Virtex7/Carbonwickelmaschine/README.md

# Carbonwickelmaschine
Maschine zur Herstellung von gewickelten Carbonrohren
