Virtex7/Carbonwickelmaschine/Doku/Pläne gescannt.pdf

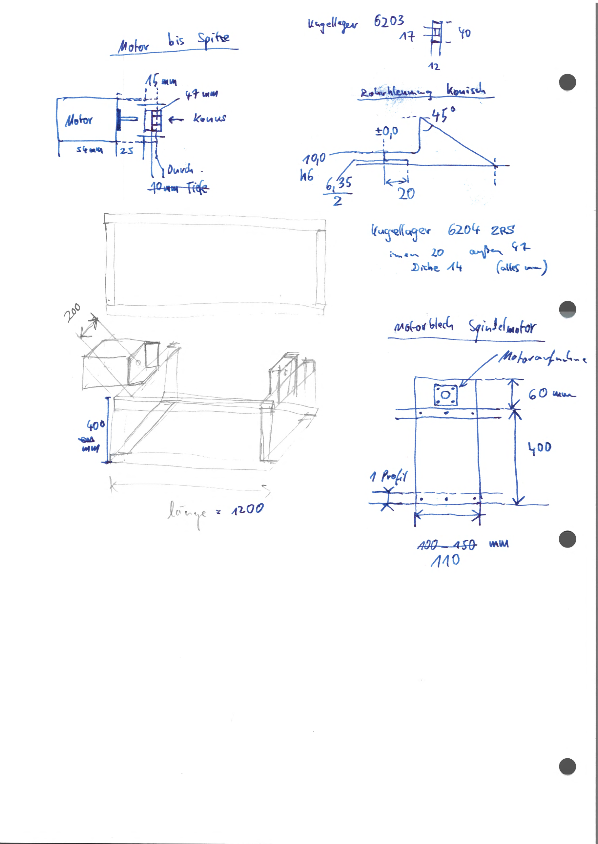
[picture p12: page 1]

00~

# ovv

## (j(jb' ~ fil WIWI

- •

# ~,3..'cr JiY ~l~ -""' (

! ...... „ ..... 07 "-~ ;..~

# '0hn_)}aJ;Y\J} +J07fj St}Z

:+ o'o

()07.V

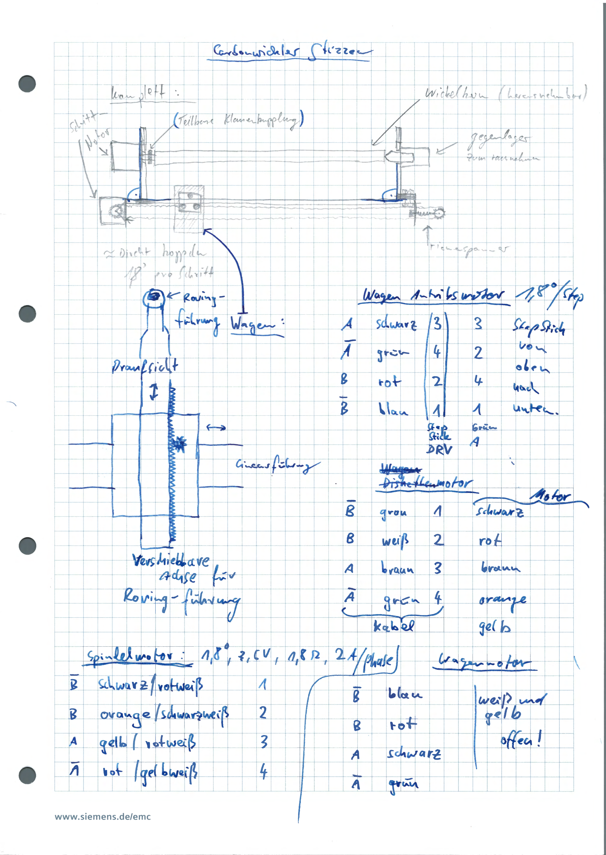
[picture p13: page 2]

l

. h V J -=+--+-l-~--+----1------+- -- -- > 4 | ,, ; l~ ifl ~_iill ,r'ta: -n 1t-i-

-1--_.__ ..-i-- ----+- --+---+----+-'--+--+-1--+--+- - - .--r--t--+--4
, I

o:; •J1 lt"" _. F~) l'- r• - '7- 1

I--+-+---+-~ .,f-- -+--00

1

... . ..._ . ~ ........., - -_ . ... : [ _.!"" ~ ""' I _ +-. ~--+- --

' - 1 q

- -l---j---1--~ --+-- ---B- +-1--+---+---i--+-+-+--+--+ ~ z rt r 11

\.

### oJ. „ v ~

~ -

1

~ .- ·~

# _. -·rr ... IJ -. j

1 1 - 1
