Virtex7/Carbonwickelmaschine/Doku/bilder/carbonwickler_matlab.jpg

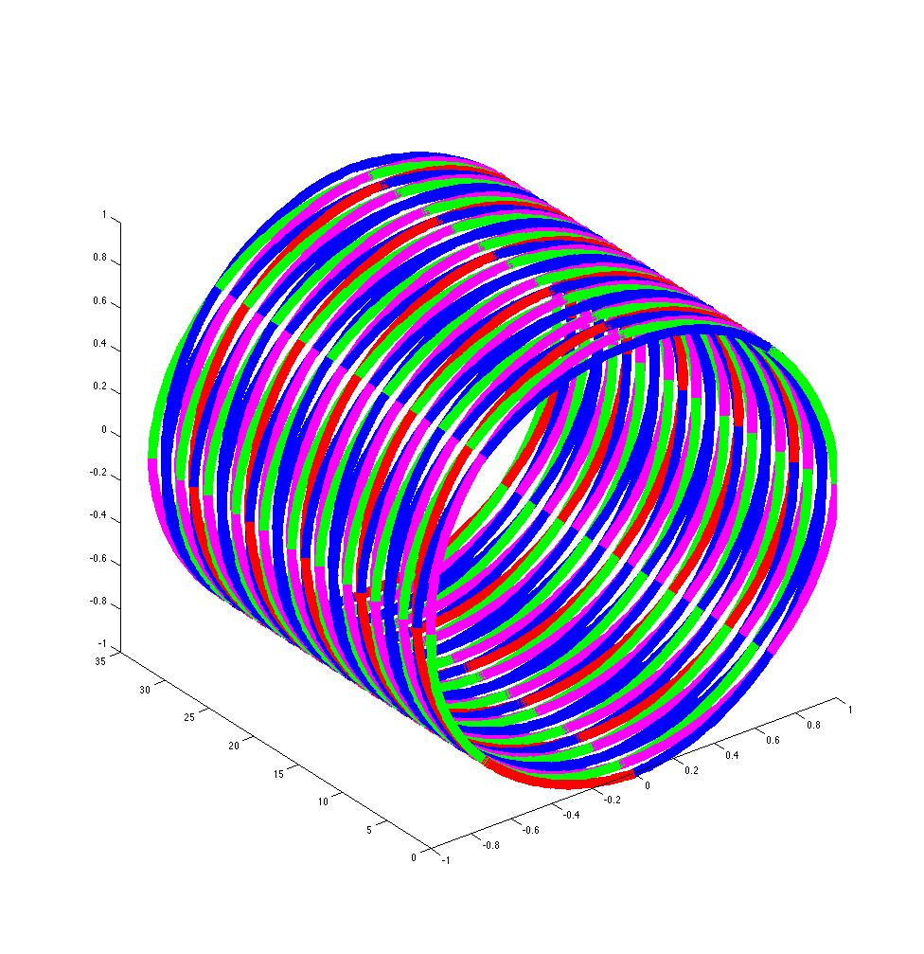
Doku/bilder/carbonwickler_matlab.jpg
