Virtex7/Carbonwickelmaschine/Doku/carbonwickler.png

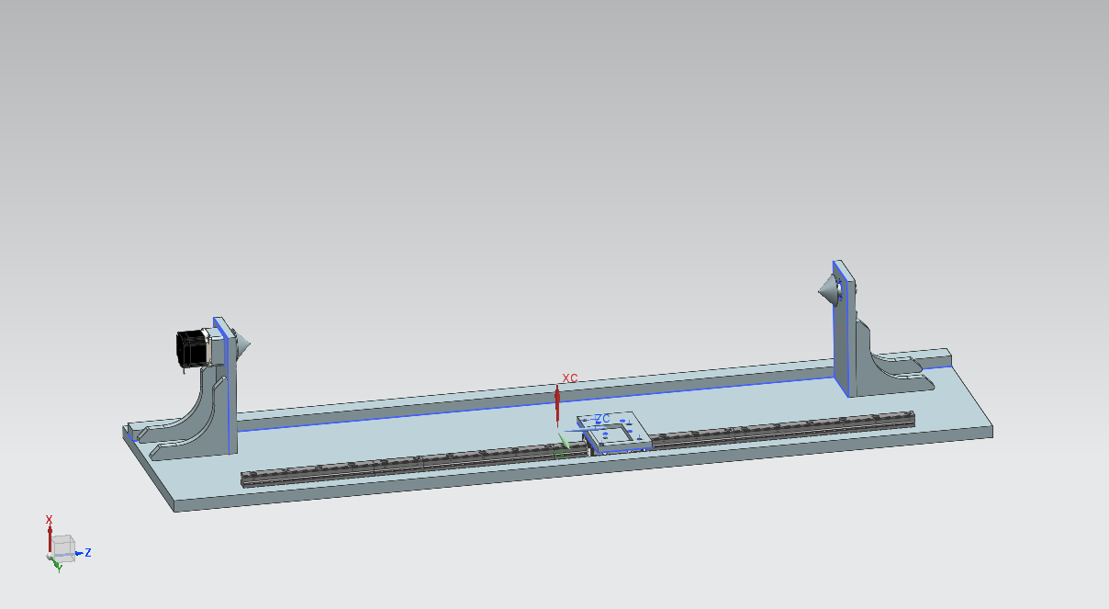
Doku/carbonwickler.png
