Virtex7/Carbonwickelmaschine/Doku/NX_Screenshots/arm_hinten.png

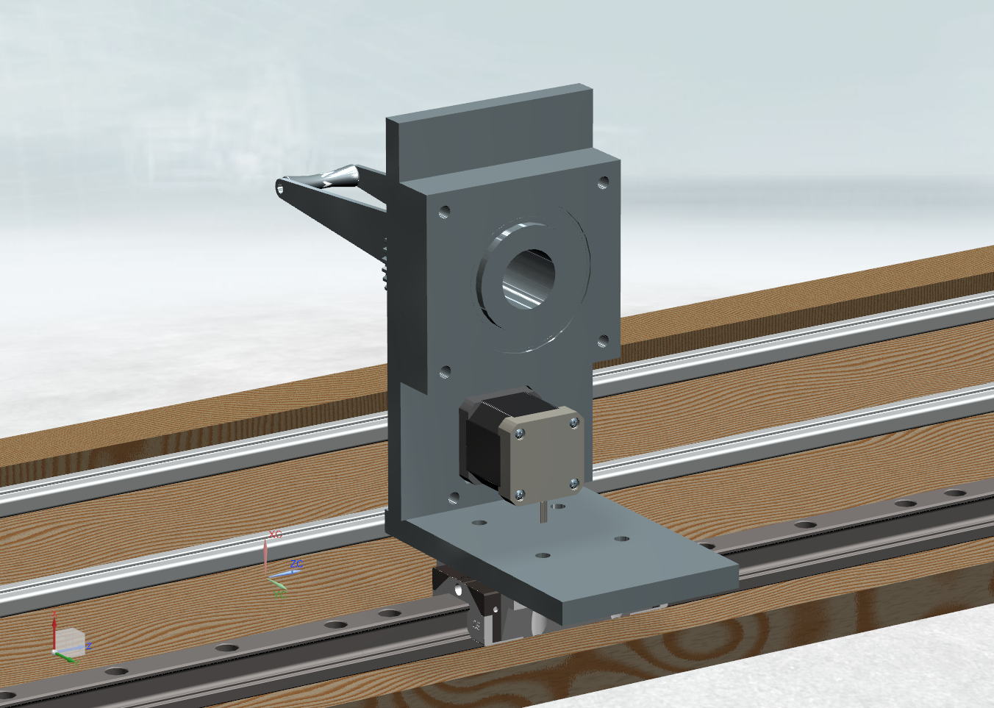
Doku/NX_Screenshots/arm_hinten.png
