Virtex7/Carbonwickelmaschine/Doku/NX_Screenshots/dreharm.png

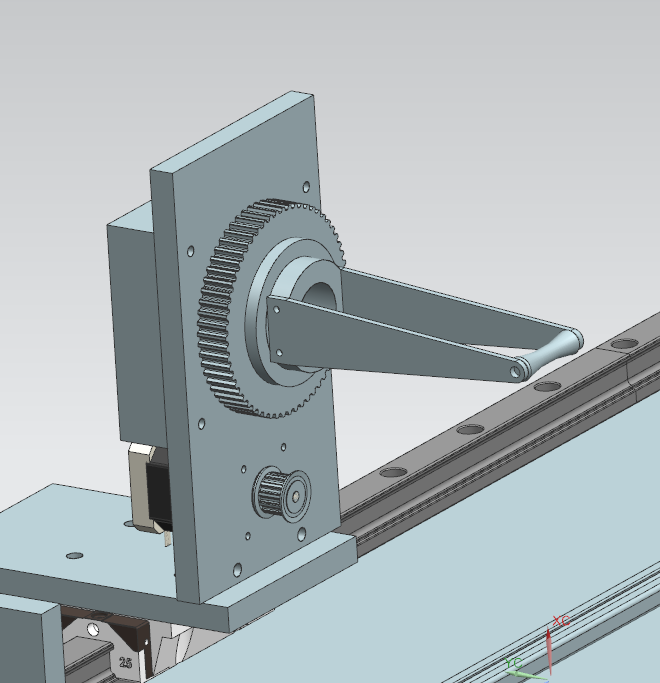
Doku/NX_Screenshots/dreharm.png
