Virtex7/Carbonwickelmaschine/Doku/NX_Screenshots/dreharm_rueckseite.png

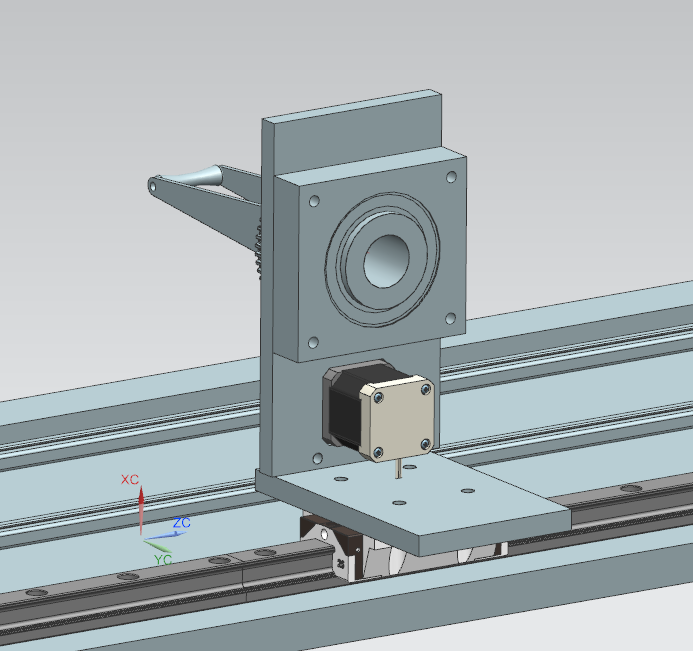
Doku/NX_Screenshots/dreharm_rueckseite.png
