Virtex7/Carbonwickelmaschine/Doku/NX_Screenshots/gesamt2.png

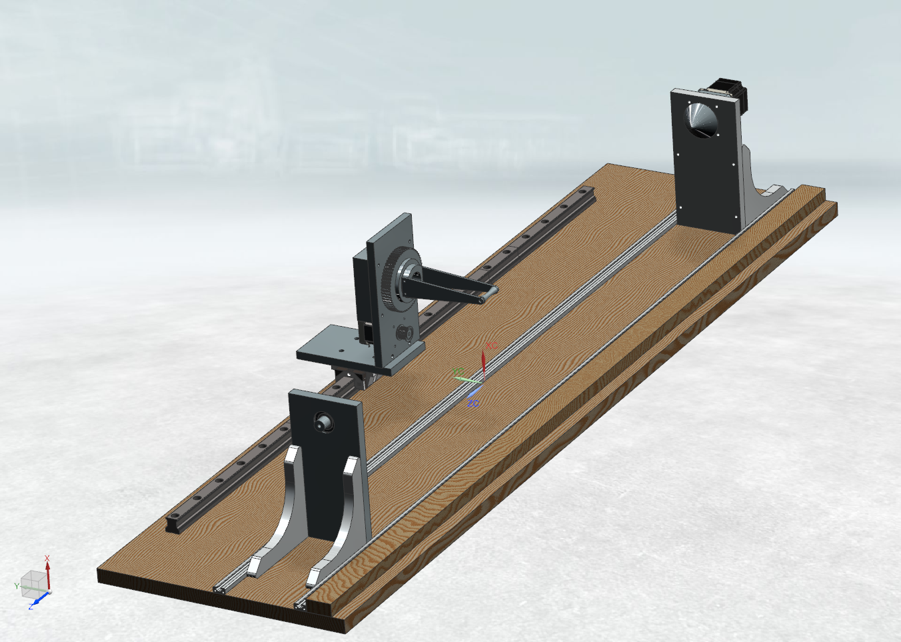
Doku/NX_Screenshots/gesamt2.png
