Virtex7/Carbonwickelmaschine/Doku/NX_Screenshots/gesamt.png

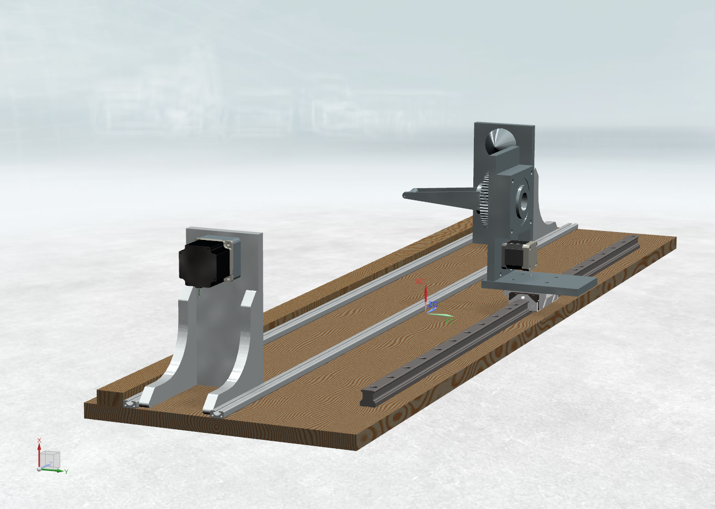
Doku/NX_Screenshots/gesamt.png
