Virtex7/Carbonwickelmaschine/Doku/NX_Screenshots/kugelumlaufführung_wagen.png

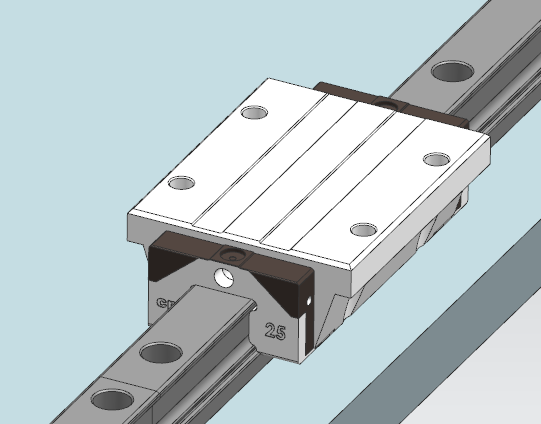
Doku/NX_Screenshots/kugelumlaufführung_wagen.png
