Virtex7/Carbonwickelmaschine/Doku/NX_Screenshots/oben.png

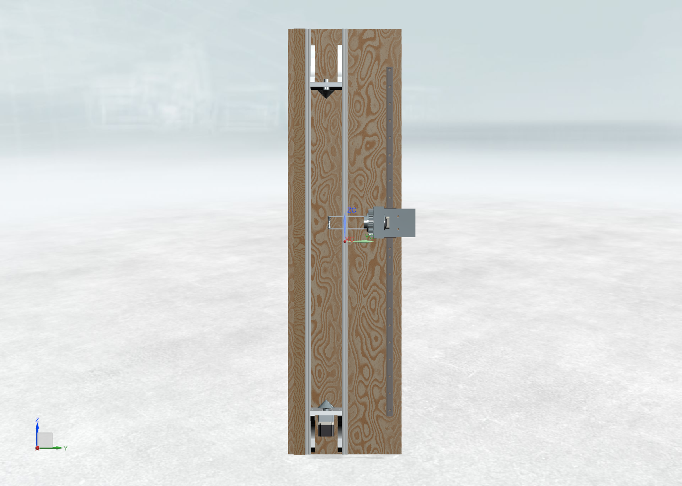
Doku/NX_Screenshots/oben.png
