Virtex7/Carbonwickelmaschine/Doku/NX_Screenshots/reitstock.png

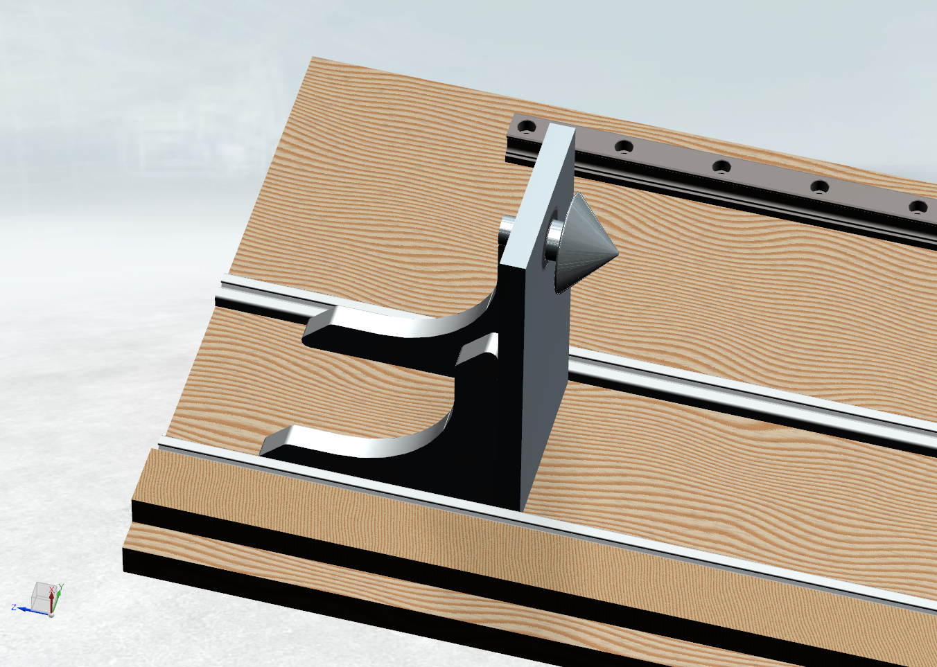
Doku/NX_Screenshots/reitstock.png
