Virtex7/Carbonwickelmaschine/Doku/NX_Screenshots/spindel_hinten.png

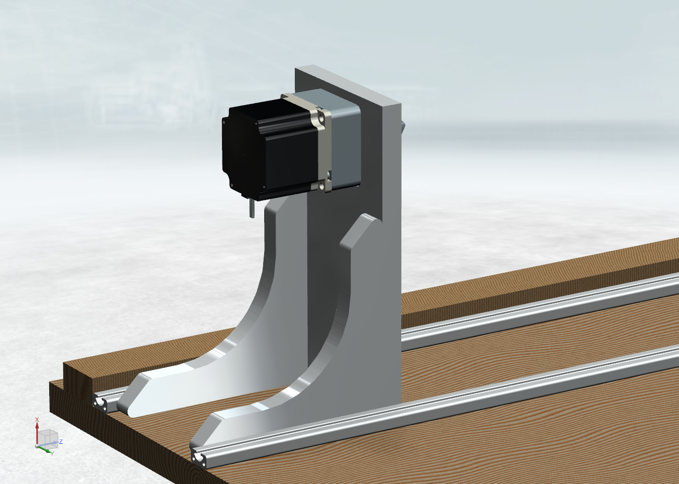
Doku/NX_Screenshots/spindel_hinten.png
