Virtex7/Carbonwickelmaschine/Doku/NX_Screenshots/spindel_rueckseite.png

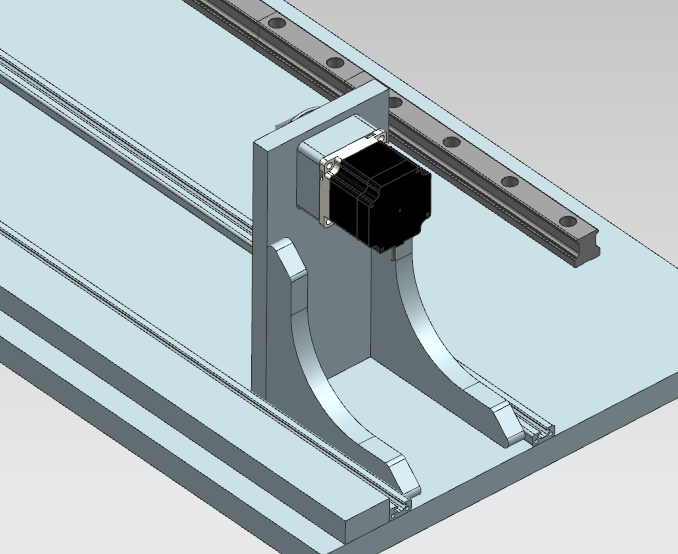
Doku/NX_Screenshots/spindel_rueckseite.png
