Virtex7/Carbonwickelmaschine/Doku/NX_Screenshots/spindel_vorderseite.png

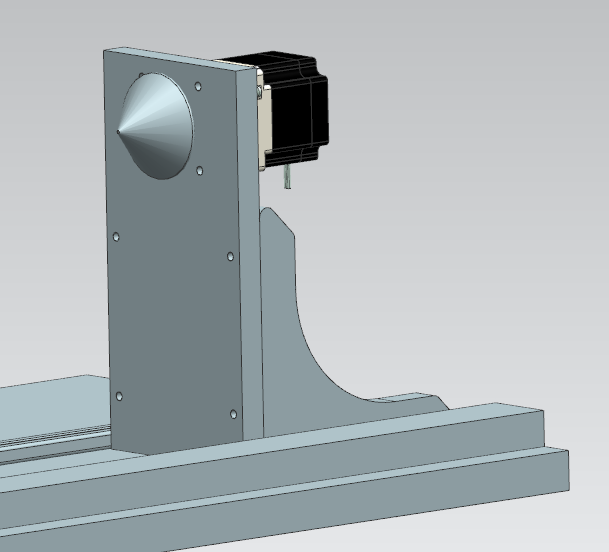
Doku/NX_Screenshots/spindel_vorderseite.png
