Virtex7/Carbonwickelmaschine/3D-Modell/extern/ST5918S3008.stp

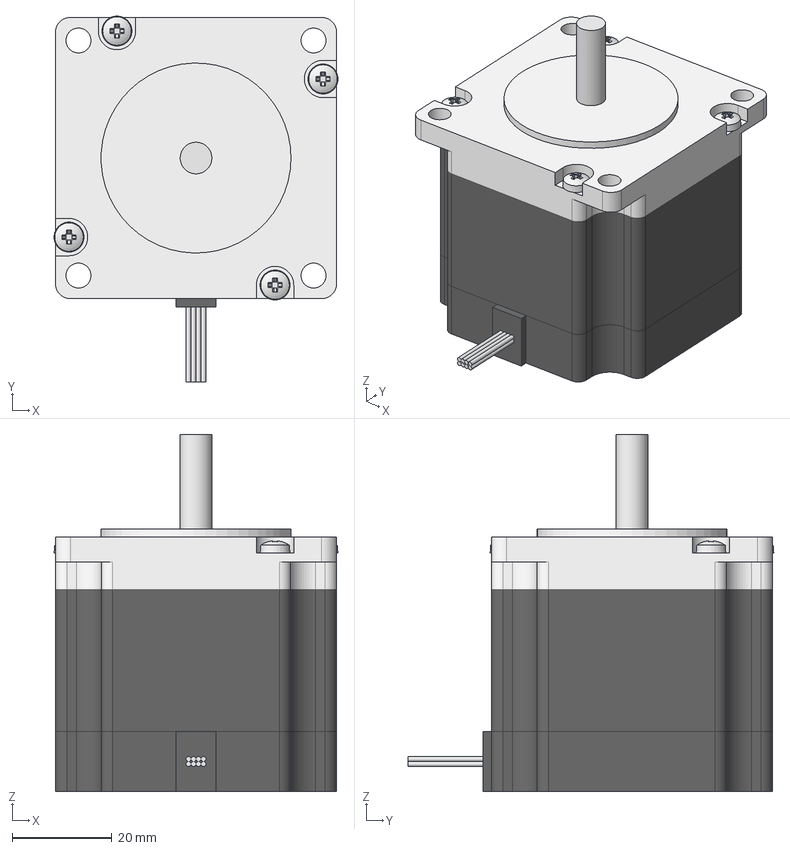
[picture p27: CAD file, 2015-10-22]
3D-Modell/extern/ST5918S3008.stp
56.9 x 73.4 x 71.6 mm
