Virtex7/Carbonwickelmaschine/3D-Modell/extern/62032rsr.stp

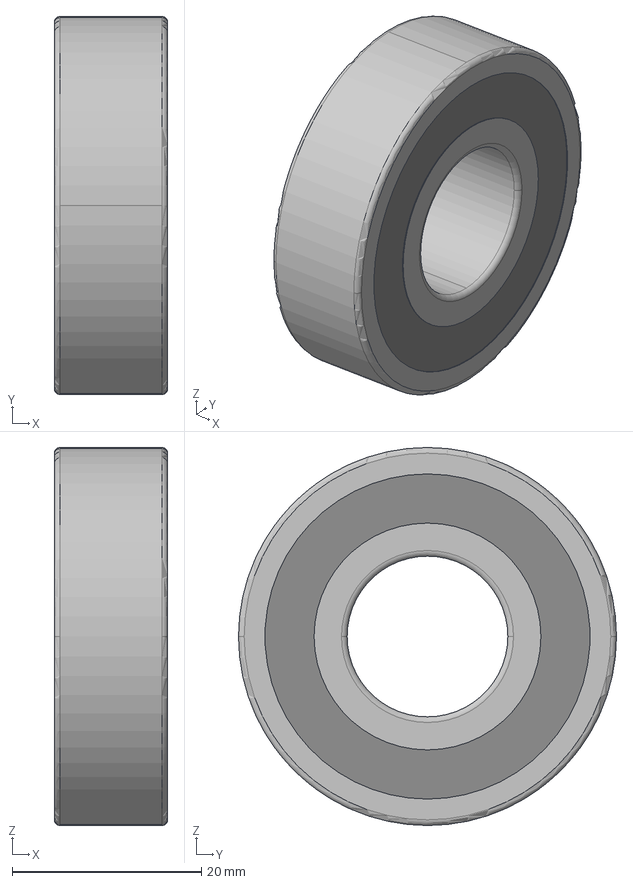
[picture p28: CAD file, 2015-10-22]
3D-Modell/extern/62032rsr.stp
12.0 x 40.0 x 40.0 mm
