Virtex7/Carbonwickelmaschine/(list of files, cad)

Other CAD files:
3D-Modell/1.prt
3D-Modell/1216.prt
3D-Modell/2.prt
3D-Modell/2230.prt
3D-Modell/3.prt
3D-Modell/3244.prt
3D-Modell/4.prt
3D-Modell/4258.prt
3D-Modell/5.prt
3D-Modell/5272.prt
3D-Modell/6.prt
3D-Modell/6203_2RSR.prt
3D-Modell/6286.prt
3D-Modell/7.prt
3D-Modell/7300.prt
3D-Modell/8.prt
3D-Modell/8314.prt
3D-Modell/9.prt
3D-Modell/9328.prt
3D-Modell/AR25M-RAIL.prt
3D-Modell/Aluprofil_20_10_5.prt
3D-Modell/Grundplatte.prt
3D-Modell/HRC25FL-BLOCK.prt
3D-Modell/Montagewinkel150x150.prt
3D-Modell/Nema17Stepper49mm.prt
3D-Modell/Reitstock.prt
3D-Modell/Reitstockblech.prt
3D-Modell/Rillenkugellager_60102RSR.prt
3D-Modell/Rohrkonus_links.prt
3D-Modell/ST5918S3008_stp.prt
3D-Modell/Spindelblech.prt
3D-Modell/Spindelgruppe.prt
3D-Modell/Spindelmotorhalter-fraesen.prt
3D-Modell/Spindelmotorhalter.prt
3D-Modell/Umlenkrolle.prt
3D-Modell/Zahnriemenrad_21T5_12.prt
3D-Modell/Zahnriemenrad_21T5_60.prt
3D-Modell/_HSR15A115015 Rail.prt
3D-Modell/_HSR15ASSQZ Slider.prt
3D-Modell/_hsr_ftht__grease_nipple_joint.prt
3D-Modell/carbonwickler.prt
3D-Modell/carbonwickler_fertigung_montagewinkel.prt
3D-Modell/drehachse.prt
3D-Modell/dreharm_seitenplatten.prt
3D-Modell/dreharm_welle.prt
3D-Modell/extern/1.prt
3D-Modell/extern/2.prt
3D-Modell/extern/3.prt
3D-Modell/extern/4.prt
3D-Modell/extern/5.prt
3D-Modell/extern/6.prt
3D-Modell/extern/6203_2RSR.prt
3D-Modell/extern/7.prt
3D-Modell/extern/8.prt
3D-Modell/extern/9.prt
3D-Modell/extern/ST5918S3008_stp.prt
3D-Modell/fertigung_frontlblech_drehwagen.prt
3D-Modell/fertigung_grundplatte_drehplattenhalter.prt
3D-Modell/fertigung_motorhalter.prt
3D-Modell/grundplatte_drehplattenhalter.prt
3D-Modell/kleine_linearfuehrung_x_achse.prt
3D-Modell/lagerbock_dreharm_welle.prt
3D-Modell/reitstock_anschlag.prt
3D-Modell/wagen_drehplattenhalter.prt
3D-Modell/wickelwagen.prt
3D-Modell/wickelwagen_fertigung.prt
3D-Modell/x_achse.prt
3D-Modell/x_achse_grundplatte.prt
3D-Modell/x_achse_unterbau.prt
