Virtex7/Carbonwickelmaschine/(commit log)

2015-10-21 submodules und erste NX-Files dazugefügt.
    [Spindelblech.prt, Spindelgruppe.prt, Spindelmotorhalter-fraesen.prt, Spindelmotorhalter.prt]
2015-10-22 3d modell weiter und Motor hinzugefügt
    [Grundplatte.prt, Montagewinkel150x150.prt, ST5918S3008.CATPart, ST5918S3008.stp, Spindelblech.prt, Spindelgruppe.prt, carbonwickler.prt]
2015-10-22 weitergemacht am 3d modell und neue Teile dazugefügt
    [1.prt, 2.prt, 3.prt, 4.prt, 5.prt, 6.prt, 62032rsr.stp, 6203_2RSR.prt]
2015-10-23 Berechnungen für die Wickelhelix zur Doku hinzugefügt
2015-10-23 Spindelstock und Anschlagsschiene hinzugefügt
    [1.prt, 2.prt, 3.prt, 4.prt, 5.prt, 6.prt, 6203_2RSR.prt, 7.prt]
2015-10-26 linearführung hinzugefügt spitzenhöhe angepasst
    [AR25M-RAIL.prt, HRC25FL-BLOCK.prt, Reitstock.prt, Reitstockblech.prt, Spindelblech.prt, Spindelgruppe.prt, carbonwickler.prt]
2015-10-26 an x achse weitergearbeitet
    [carbonwickler.prt, x_achse.prt, x_achse_grundplatte.prt, x_achse_unterbau.prt]
2015-10-26 Fertigungsdatei für die Montagewinkel erstellt.
    [carbonwickler_fertigung_montagewinkel.prt]
2015-10-28 X-Achsen-Aufbau angefangen, Kugellager und kleinen Motor angelegt sowie verwendet
    [Nema17Stepper49mm.prt, Rillenkugellager_60102RSR.prt, Zahnriemenrad_21T5_12.prt, Zahnriemenrad_21T5_60.prt, carbonwickler.prt, drehachse.prt, fertigung_motorhalter.prt, wagen_drehplattenhalter.prt]
2015-10-29 fehlende prt Dateien für das 6010 Lager
    [1216.prt, 2230.prt, 3244.prt, 4258.prt, 5272.prt, 6286.prt, 7300.prt, 8314.prt]
2016-01-10 teststand, ui angelegt
    [ST5918S3008_stp.prt]
2016-01-11 gcode wird erzeugt, ein paar rechnungen fehlen noch
2016-01-11 änderungen am 3D Modell
    [1.prt, 1216.prt, 2.prt, 2230.prt, 3.prt, 3244.prt, 4.prt, 4258.prt]
2016-01-18 Dreharm hinzugefügt zweites Lager Dreharm hinzugefügt 20x10 Aluprofil hinzugefügt
    [Aluprofil_20_10_5.prt, Umlenkrolle.prt, carbonwickler.prt, dreharm_seitenplatten.prt, dreharm_welle.prt, lagerbock_dreharm_welle.prt, reitstock_anschlag.prt, wagen_drehplattenhalter.prt]
2016-01-18 Entwurf für die DIY Website erstellt
2016-01-22 Materialien zugewiesen Wiki weitergeschrieben
    [AR25M-RAIL.prt, Aluprofil_20_10_5.prt, Grundplatte.prt, Montagewinkel150x150.prt, Spindelblech.prt, carbonwickler.prt, reitstock_anschlag.prt]
2016-01-23 Grundlagen und Mechanik weitergeschrieben
2016-01-24 die mathematik des wickelns bekommt formeln...
2016-01-24 kleine Änderung für Screenshots
    [carbonwickler.prt]
2016-01-24 bibtex File hinzugefügt, um Quellen managen zu können text der Mechanik weitergeschrieben
2016-02-01 Bild von grbl-board hinzugefügt
2016-02-06 Reihenfolge der Seiten geändert
2016-02-06 Doku im ieee angelegt auf Basis der Vorlage von der IEEE Website
2016-02-06 Bilder angepasst H-->h sowie die Bildbreite
2016-02-07 quellenverzeichnis und querverweise hinzugefügt
2016-09-20 wickelwagen (X-Achse) weitergemacht und kleine Linearführung für X-Achse montiert
    [_HSR15A115015 Rail.prt, _HSR15ASSQZ Slider.prt, _hsr_ftht__grease_nipple_joint.prt, carbonwickler.prt, grundplatte_drehplattenhalter.prt, kleine_linearfuehrung_x_achse.prt, wagen_drehplattenhalter.prt, wickelwagen.prt]
2016-10-19 3d-modell quasi fertiggestellt, Aufbau schreitet voran
    [1.prt, 1216.prt, 2.prt, 2230.prt, 3.prt, 3244.prt, 4.prt, 4258.prt]
