Virtex7/Carbonwickelmaschine/(notices)

Notices in the files:
Doku/ieee_doku.tex:
This work is distributed under the LaTeX Project Public License (LPPL)
